thinkfat/led-tile/pcb/led-tile/bcl4v3.kicad_pcb

## KiCad design pcb/led-tile/bcl4v3.kicad_pcb (2019-03-24)

Schematic: bcl4v3.sch

Parts:
BOOT0: B3U-1000P; Switch_Tactile_SMD_B3U-1000P; MPN B3U-1000P; Digi-Key_PN SW1020CT-ND
C1: 22µF; CP_EIA-3528-15_AVX-H_Pad1.50x2.35mm_HandSolder
C3, C4: 4.7u; C_0805_2012Metric_Pad1.15x1.40mm_HandSolder
C5, C6, C7, C8: 100n; C_0805_2012Metric_Pad1.15x1.40mm_HandSolder
D1: SM0805HCL; LED_0805_2012Metric_Castellated
DS1: LDM-1588BS; DIPS2794W50P254L3800H1065Q16N; Manufacturer_Part_Number TC15-11SRWA
J1, J2, J3, J5, J6, J7, J8, J10: Conn_01x04; PinHeader_1x04_P2.54mm_Vertical
J4: Conn_01x05; PinHeader_1x05_P2.54mm_Vertical
J9: 10118194-0001LF; USB_Micro_B_Female_10118194-0001LF; MPN 10118194-0001LF; Digi-Key_PN 609-4618-1-ND
JP1: Jumper; SMT-JUMPER_2_NC_TRACE_NO-SILK
LOGO1: OSHW-LOGOM; OSHW-LOGO-M
Q1: IRLML6402; SOT-23
R1, R2: 1k; R_0805_2012Metric_Pad1.15x1.40mm_HandSolder
R4: 715R; R_0805_2012Metric_Pad1.15x1.40mm_HandSolder
TP1, TP2, TP3, TP4: TestPoint; TestPoint_THTPad_1.0x1.0mm_Drill0.5mm
U1: STM32F072CBTx; LQFP-48_7x7mm_P0.5mm
U2: 74HC595D_118; TSSOP-16_4.4x5mm_P0.65mm; MPN 74HC595D,118; Digi-Key_PN 1727-2821-1-ND
U3: TBD62783A; SSOP-18_4.4x6.5mm_P0.65mm
U4: TLC5916ID; TSSOP-16_4.4x5mm_P0.65mm; MPN TLC5916ID; Digi-Key_PN 296-24383-5-ND
U5: MCP1703A-3302_SOT23; SOT-23
Y1: ABS07-120-32.768KHZ-Z; Crystal_SMD_MicroCrystal_CC7V-T1A-2Pin_3.2x1.5mm

Connections:
+3V3: BOOT0.1, C4.1, C5.1, C6.1, C7.1, C8.1, D1.2 (A), U1.9 (VDDA), U1.24 (VDD), U1.36 (VDDIO2), U1.48 (VDD), U2.10 (MR), U2.16 (VCC), U4.16 (VDD), U5.2 (VO)
+5V: C3.1, JP1.2, Q1.2 (S), U3.9 (VCC), U5.3 (VI)
/BOOT0: BOOT0.2, R2.1, U1.44 (BOOT0)
/CAT_CLK: TP1.1, U1.39 (PB3), U2.11 (SHCP), U4.3 (CLK)
/CAT_DATA: TP3.1, U1.41 (PB5), U2.14 (DS)
/CAT_STROBE: TP2.1, U1.38 (PA15), U2.12 (STCP), U4.4 (LE(ED1))
/COL_1: DS1.13 (C1), U4.5 (~OUT0)
/COL_2: DS1.3 (C2), U4.6 (~OUT1)
/COL_3: DS1.4 (C3), U4.7 (~OUT2)
/COL_4: DS1.10 (C4), U4.8 (~OUT3)
/COL_5: DS1.6 (C5), U4.9 (~OUT4)
/COL_6: DS1.11 (C6), U4.10 (~OUT5)
/COL_7: DS1.15 (C7), U4.11 (~OUT6)
/COL_8: DS1.16 (C8), U4.12 (~OUT7)
/LED: R4.2, U1.5 (PF0)
/OSC_IN: U1.3 (PC14), Y1.1
/OSC_OUT: U1.4 (PC15), Y1.2
/ROW_1: DS1.9 (R1), U3.18 (O1)
/ROW_2: DS1.14 (R2), U3.17 (O2)
/ROW_3: DS1.8 (R3), U3.16 (O3)
/ROW_4: DS1.12 (R4), U3.15 (O4)
/ROW_5: DS1.1 (R5), U3.14 (O5)
/ROW_6: DS1.7 (R6), U3.13 (O6)
/ROW_7: DS1.2 (R7), U3.12 (O7)
/ROW_8: DS1.5 (R8), U3.11 (O8)
/SWCLK: J10.2, U1.37 (PA14)
/SWDIO: J10.3, U1.34 (PA13)
/SYN_RX: J2.4, J3.4, J6.4, J7.4, U1.45 (PB8)
/SYN_TX: J1.4, J4.4, J5.4, J8.4, U1.46 (PB9)
/UART1_RX: J2.3, U1.43 (PB7)
/UART1_TX: J1.3, U1.42 (PB6)
/UART2_RX: J3.3, U1.13 (PA3)
/UART2_TX: J4.3, U1.12 (PA2)
/UART3_RX: J6.3, U1.22 (PB11)
/UART3_TX: J5.3, U1.21 (PB10)
/UART4_RX: J7.3, U1.11 (PA1)
/UART4_TX: J8.3, U1.10 (PA0)
/USB_D+: J9.3, U1.33 (PA12)
/USB_D-: J9.2, U1.32 (PA11)
/USB_VBUS: J4.5, J9.1, JP1.1
/VBAT: TP4.1, U1.1 (VBAT)
/nOE_COL: U1.40 (PB4), U4.13 (~OE~(ED2))
/nOE_ROW: U1.31 (PA10), U2.13 (OE)
/nRST: J10.4, U1.7 (NRST)
GND: C1.2, C3.2, C4.2, C5.2, C6.2, C7.2, C8.2, J1.1, J2.1, J3.1, J4.1, J5.1, J6.1, J7.1, J8.1, J9.5, J9.SH, J10.1, Q1.1 (G), R1.2, R2.2, U1.8 (VSSA), U1.23 (VSS), U1.35 (VSS), U1.47 (VSS), U2.8 (GND), U3.10 (GND), U4.1 (GND), U5.1 (GND)
unnamed: D1.1 (K), R4.1
unnamed: R1.1, U4.15 (R-EXT)
unnamed: U2.1 (Q1), U3.2 (I2)
unnamed: U2.2 (Q2), U3.3 (I3)
unnamed: U2.3 (Q3), U3.4 (I4)
unnamed: U2.4 (Q4), U3.5 (I5)
unnamed: U2.5 (Q5), U3.6 (I6)
unnamed: U2.6 (Q6), U3.7 (I7)
unnamed: U2.7 (Q7), U3.8 (I8)
unnamed: U2.9 (Q7S), U4.2 (SDI)
unnamed: U2.15 (Q0), U3.1 (I1)
VCC: C1.1, J1.2, J2.2, J3.2, J4.2, J5.2, J6.2, J7.2, J8.2, Q1.3 (D)

Notes on the sheet:
8x8 LED Matrix Display
Status LED
Display Driver
Micro Controller
Power Supply Decoupling
Boot Select
Connectors
USB
Programming / Debug

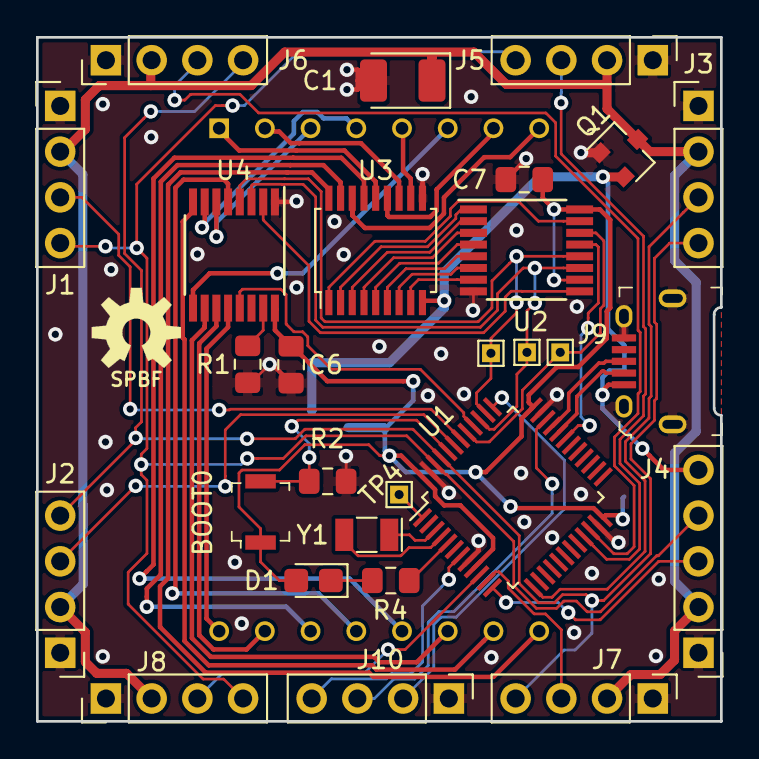
[picture p1: board bcl4v3.kicad_pcb from above]

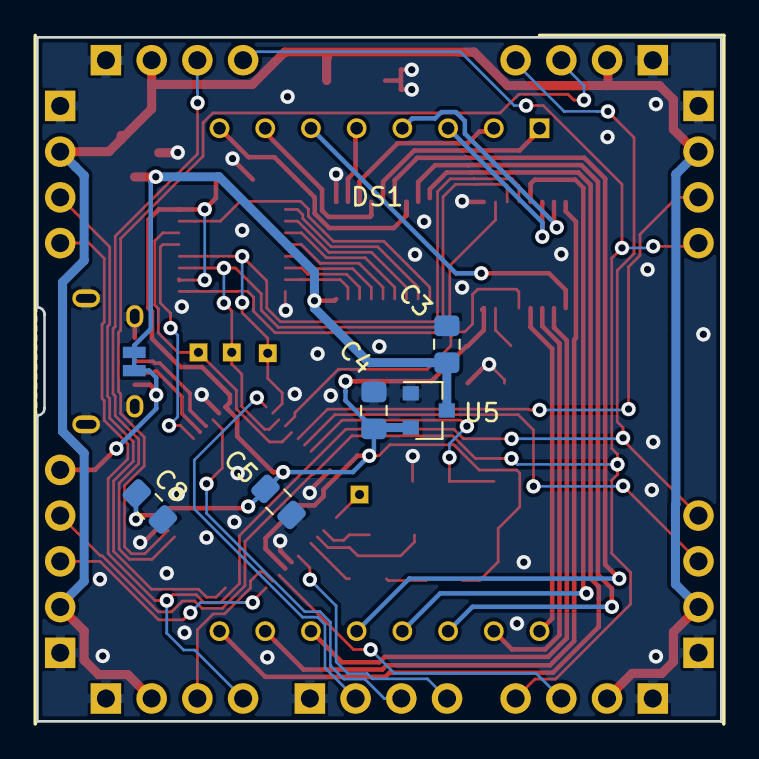
[picture p2: board bcl4v3.kicad_pcb from below]

Board: 2 copper layers, 38.0 x 38.0 mm, 36 parts (7 on the bottom side), 57 nets.
