thinkfat/led-tile/pcb/battery-manager/battery-manager.kicad_pcb

## KiCad design pcb/battery-manager/battery-manager.kicad_pcb (2019-03-24)

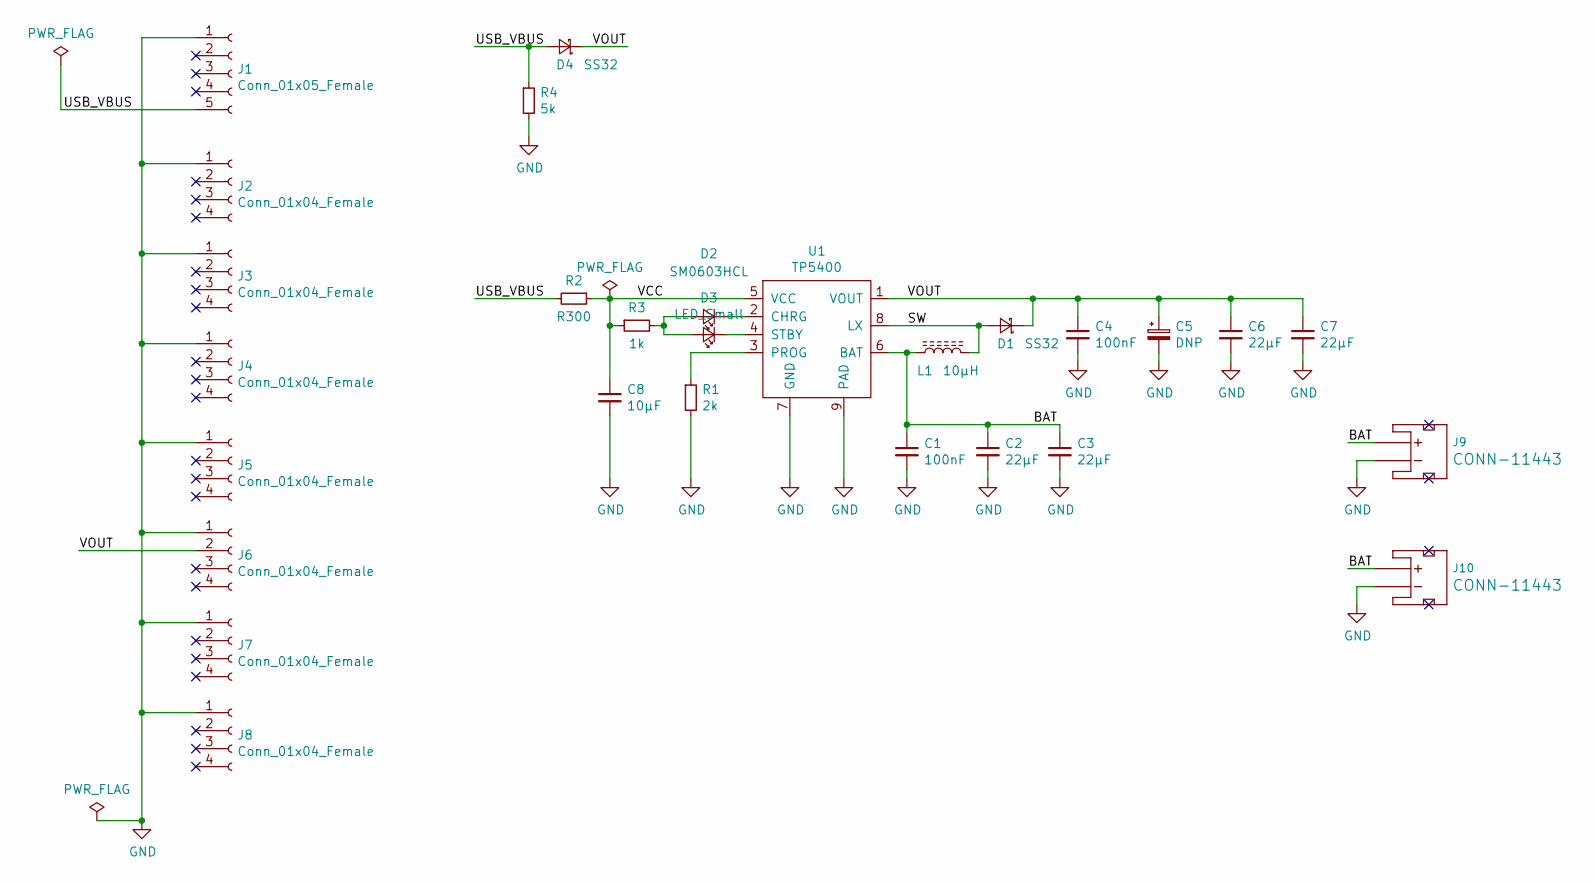
[picture p3: schematic battery-manager.sch]

Parts:
C1, C4: 100nF; C_0805_2012Metric
C2, C3, C6, C7: 22µF; C_1206_3216Metric
C5: DNP; CP_Elec_5x5.7
C8: 10µF; C_1206_3216Metric
D1, D4: SS32; D_SMA
D2: SM0603HCL; LED_0603_1608Metric_Castellated
D3: LED_Small; LED_0603_1608Metric_Castellated
J1: Conn_01x05_Female; PinSocket_1x05_P2.54mm_Vertical
J2, J3, J4, J5, J6, J7, J8: Conn_01x04_Female; PinSocket_1x04_P2.54mm_Vertical
J9, J10: JST_2MM_MALE; JST-2-SMD
L1: 10µH; L_Taiyo-Yuden_NR-40xx
R1: 2k; R_0805_2012Metric
R2: R300; R_1206_3216Metric
R3: 1k; R_0805_2012Metric
R4: 5k; R_0805_2012Metric
U1: TP5400; SOIC-8-1EP_3.9x4.9mm_P1.27mm_EP2.35x2.35mm

Connections:
/BAT: C1.1, C2.1, C3.1, J9.2 (+), J10.2 (+), L1.2, U1.6 (BAT)
/SW: D1.2 (A), L1.1, U1.8 (LX)
/USB_VBUS: D4.2 (A), J1.5, R2.2, R4.1
/VCC: C8.1, R2.1, R3.1, U1.5 (VCC)
/VOUT: C4.1, C5.1, C6.1, C7.1, D1.1 (K), D4.1 (K), J6.2, U1.1 (VOUT)
GND: C1.2, C2.2, C3.2, C4.2, C5.2, C6.2, C7.2, C8.2, J1.1, J2.1, J3.1, J4.1, J5.1, J6.1, J7.1, J8.1, J9.1 (-), J10.1 (-), R1.2, R4.2, U1.7 (GND), U1.9 (PAD)
unnamed: D2.1 (K), U1.2 (CHRG)
unnamed: D2.2 (A), D3.2 (A), R3.2
unnamed: D3.1 (K), U1.4 (STBY)
unnamed: R1.1, U1.3 (PROG)

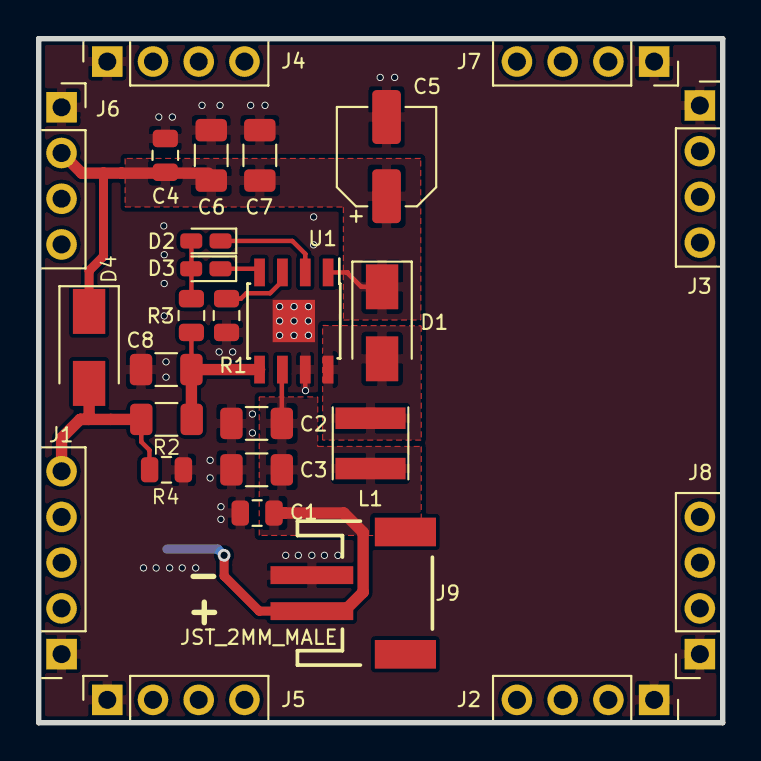
[picture p4: board battery-manager.kicad_pcb from above]

Board: 2 copper layers, 38.0 x 38.0 mm, 28 parts (1 on the bottom side), 10 nets.
