thinkfat/led-tile/(commit log)

2019-03-02 38x38mm matrix with DMA
    initial version, almost completely routed, i2c interface missing
    [bcl4v3.kicad_pcb, bcl4v3.sch]
2019-03-02 Board update
    fully routed PCB
    indicator LED added
    [bcl4v3.kicad_pcb, bcl4v3.sch]
2019-03-02 PCB and schematics updates
    - exchange STM32F070 with STM32F072 (USB w/o HSE)
    - remove xtal and related components
    - add boot mode jumper pads (NO)
    - connect USB_VBUS with VCC via jumper (NC)
    - smaller clearance for pad to solder mask
    - add local library directory for externally imported
    symbols, footprints and 3D models
    PCB outline
    add small cut-out for USB receptacle
    [bcl4v3.kicad_pcb, bcl4v3.sch]
2019-03-02 PCB updates for panelization
    - place USB receptacle and edge cut-out smack center of the right board edge
    - rounded cut-out (.4mm radius) to allow routing it out using a single
    0.8mm wide slot.
    [bcl4v3.kicad_pcb]
2019-03-02 - add missing header, more cleanup
    [disp_spi.c, dots.c, main.c, usart_buffered.c]
2019-03-02 - switch to next hw revision
2019-03-02 PCB and schematics cleanup
    resize PCB to exactly 38x38mm, center the LED matrix
    add OSHW logo to silk screen, add copyright information
    [bcl4v3.kicad_pcb, bcl4v3.sch]
2019-03-02 Fix reverse voltage protection, cleanups
    - power from USB doesn't need to go through protection FET
    - power to 3.3V LDO _must_ got through protection FET
    - add OSHW logo also to schematics so that it doesn't vanish if you
    sync PCB and schematics
    - modify copyright info a bit
    [bcl4v3.kicad_pcb, bcl4v3.sch]
2019-03-02 Add test points, small routing changes
    - add test points for SPI bus
    - add net classes for VCC and LED networks
    - small routing changes
    [bcl4v3.kicad_pcb, bcl4v3.sch]
2019-03-02 Support for 38x38 v3 tile with DMA
    Lots of changes in this one
    - display scan-out with DMA
    - remove generic timer interrupts
    - PRNG with xorshift32
    - overall clean-up, removing lots of dead and ifdef'd code,
    formatting cleanup
    - more formal ticker interface
    - mainloop executes workers instead of ISRs
    Also:
    - simple game-of-life worker for testing
2019-03-02 make life less boring
    - fix rule computation, cell death must be instant, but life may have
    shades of red
    - add a few heuristics to catch stagnant (boring) populations
    [life.c]
2019-03-02 small pcb fixes
    move USB_VBUS via out from under the USB receptacle (ouch)
    it just makes handsoldering difficult because the shield of
    the receptacle sucks up superfluous tin and then shorts
    USB_VBUS to ground
    [bcl4v3.kicad_pcb]
2019-03-02 disp: add fast version of disp_set
    add disp_set_noupdate() which only sets the display buffer
    but doesn't update the DMA row buffer. Useful for bulk
    updates of the display that touch all rows multiple times.
    also add disp_update_rows() to update all DMA row buffers
    at once.
    [disp.c, disp.h]
2019-03-02 Correct display orientation to make (0,0) top left
    hardware should be reflected in the software.
    [disp.c, disp_spi.c, hw_defs_38x38_rev_0_3.h, main.c]
2019-03-02 work around pcb bug to keep tile in sync
    still not completely OK, though.
    [life.c]
2019-03-02 life: major update
    - new protocol for edge updates to create a namespace for control messages
    - fix major bug in tile sync protocol, sync is now realiable
    - add output of trace information through cdcacm function
    - depending on which edges are adjacent to each other, state messaages
    from the neighboring tiles need to be reversed to match coordinate
    systems
    - WIP: implement tick interval change through cdcacm
    [life.c]
2019-03-02 life: switch trace output to the console layer
2019-03-02 life: fix life tick updates
    compute life tick through a multiplier and update the multiplier
    once every tick based on console input
    [life.c]
2019-03-02 usart_buffered: enable pull-ups on RX lines
    try to prevent spurious inputs on unconnected USART RX lines
    [usart_buffered.c]
2019-03-02 life: update interpretation of S23/B36 rule
    cells are born with 3 and 6 neighbors and also survive with 6 neighbors
    not sure if this is correct but the results seem to be OK.
    [life.c]
2019-03-02 Sync GPIO corrections, add tactile switch for BOOT0 signal
    [bcl4v3.kicad_pcb, bcl4v3.sch]
2019-03-02 PCB updates: 32kHz oscillator, separate VBAT supply
    also, longer pads for the row driver
    [bcl4v3.kicad_pcb, bcl4v3.sch]
2019-03-02 introduce "applet" mini-framework
    Minimal framework for "applets" running from the main loop. A
    new "struct applet" keeps pointers to an "init" and a "worker" function.
    A "struct applet" instance can be registered with the framework by the
    macro "applet_add", which puts an instance pointer into a dedicated ELF
    section. Two functions applet_init_all() and applet_run_all() are then
    called from main() to run the init and worker functions. This removes
    compile and link time dependecies and avoids using #ifdef in order to run
    a certain applet on the device.
    [applet.c, applet.h, cdcacm.c, life.c, main.c, rtc.c, wordclock.c]
2019-03-02 wordclock: small corrections
    "A QUARTER" instead of "QUARTER"
    remove an "unused function" warning
    remove a debug print
    [wordclock.c]
2019-03-02 pcb: put USB_VBUS to pin header
    Replace one pin header with a 5-contact version and route USB_VBUS
    to this pin. Necessary to power a plug-on battery shield from the main
    USB connector.
    [bcl4v3.kicad_pcb, bcl4v3.sch]
2019-03-02 pcb: add battery shield
    based on a TP5400 single-chip LiPo powerbank solution
    [battery-manager.kicad_pcb, battery-manager.sch]
2019-03-02 pcb: add 3d model for ABS07 crystal resonator
2019-03-03 firmware: fix display gpio initialization
    RCC clock defines cannot be OR'd together.
    [disp.c, hw_defs_38x38_rev_0_3.h]
2019-03-03 firmware: make led_init static
2019-03-04 pcb: add archive of used footprints
    make sure pcb can be opened even if footprint libraries are missing
2019-03-24 pcb: update battery shield pcb to latest version
    mainly, add a power path to supply the target with power when the
    TP5400 is charging the battery, as in this mode the boost converter is
    not active and the target is supplied with the current battery voltage
    [battery-manager.kicad_pcb, battery-manager.sch]
2019-03-24 pcb: add fabrication files
    gerber and drill file for current pcb.
    [battery-manager-B.Cu.gbl, battery-manager-B.Mask.gbs, battery-manager-B.Paste.gbp, battery-manager-B.SilkS.gbo, battery-manager-Edge.Cuts.gm1, battery-manager-F.Cu.gtl, battery-manager-F.Mask.gts, battery-manager-F.Paste.gtp]
2019-03-24 pcb: update led-tile to latest version
    move OSHW logo into a project specific library as not everyone has the
    Sparkfun Libraries installed, decrease current through the SMD LED,
    [bcl4v3.kicad_pcb, bcl4v3.sch]
2019-03-24 fw: reduce multiplexing frequency of matrix display
    be slower to save a bit of power
2019-03-24 fw: make sure RTC is initialized to 24h mode
    this should be the power-on default, but better be sure.
2019-05-31 pcb: add wordmask pcb
    instead of a sheet of paper, use a thin piece of PCB as a wordmask
    for the word clock
    [WordClock.kicad_pcb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]
